VishnuMano/implementing-a-risc-v-chip/results/images/23-floorplan.png

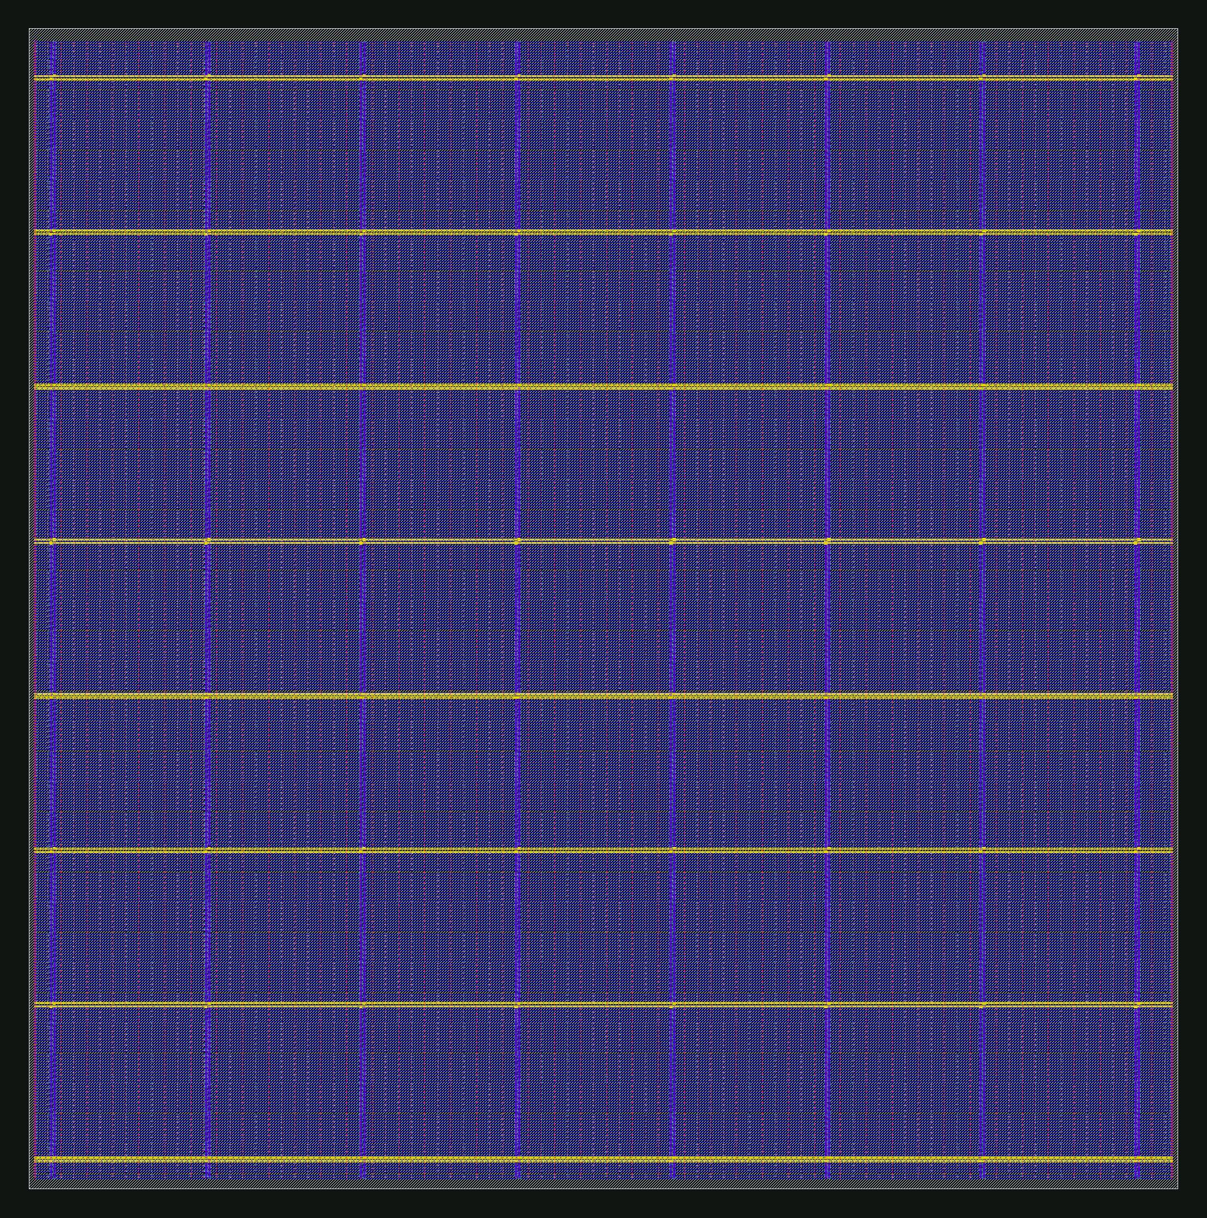
results/images/23-floorplan.png
