VishnuMano/implementing-a-risc-v-chip/results/images/31-placement.png

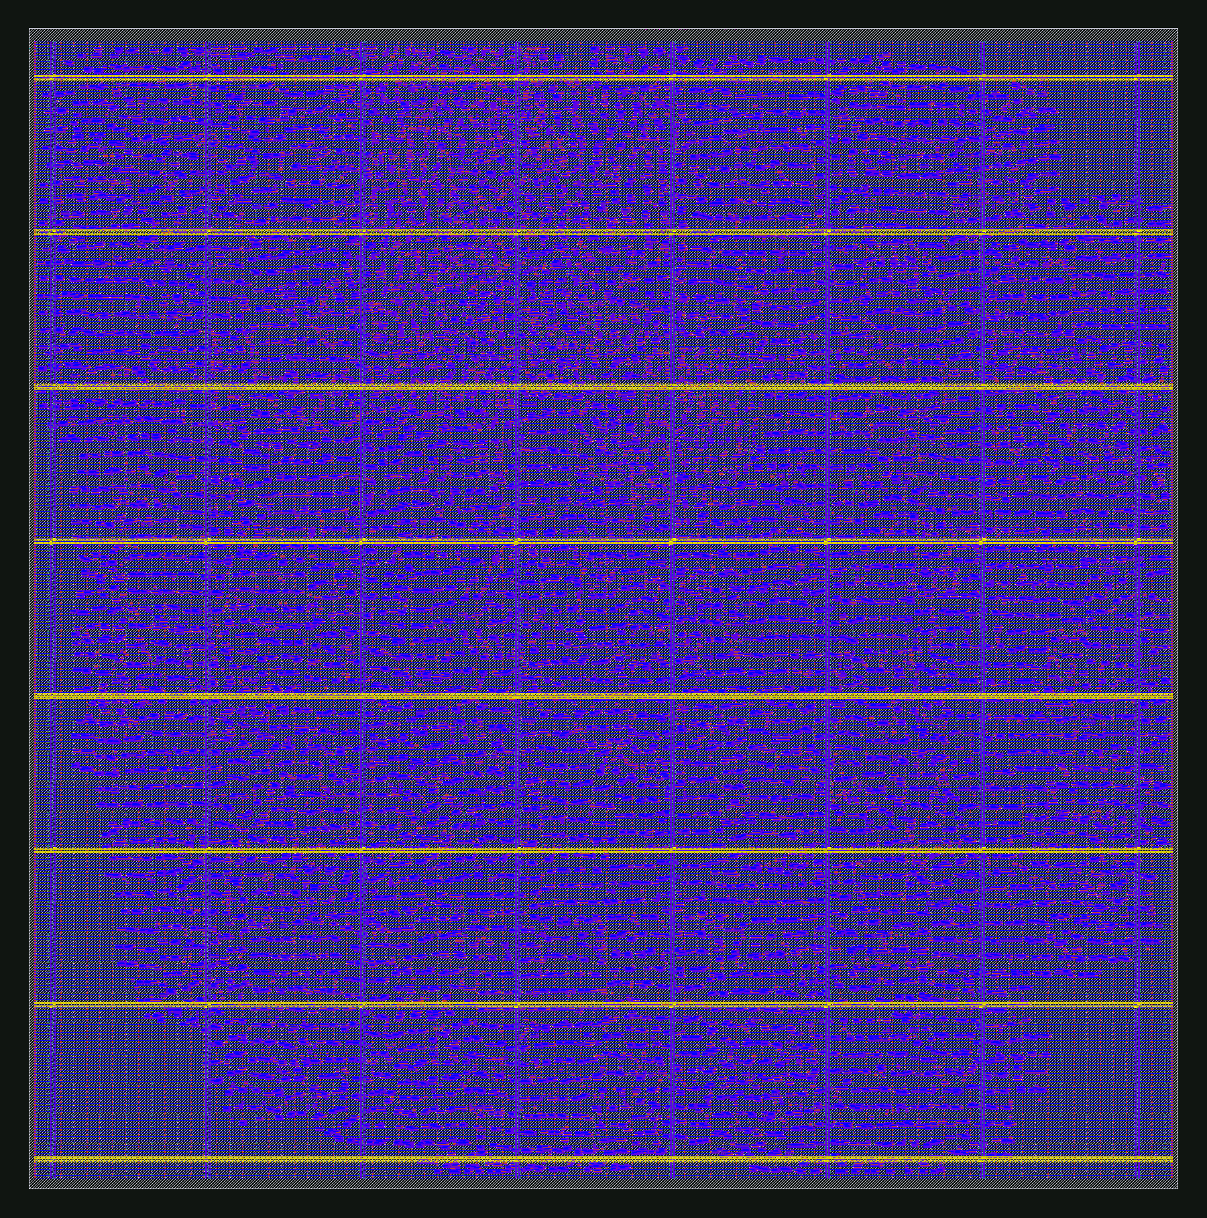
results/images/31-placement.png
