VishnuMano/implementing-a-risc-v-chip/results/images/38-clock-tree.png

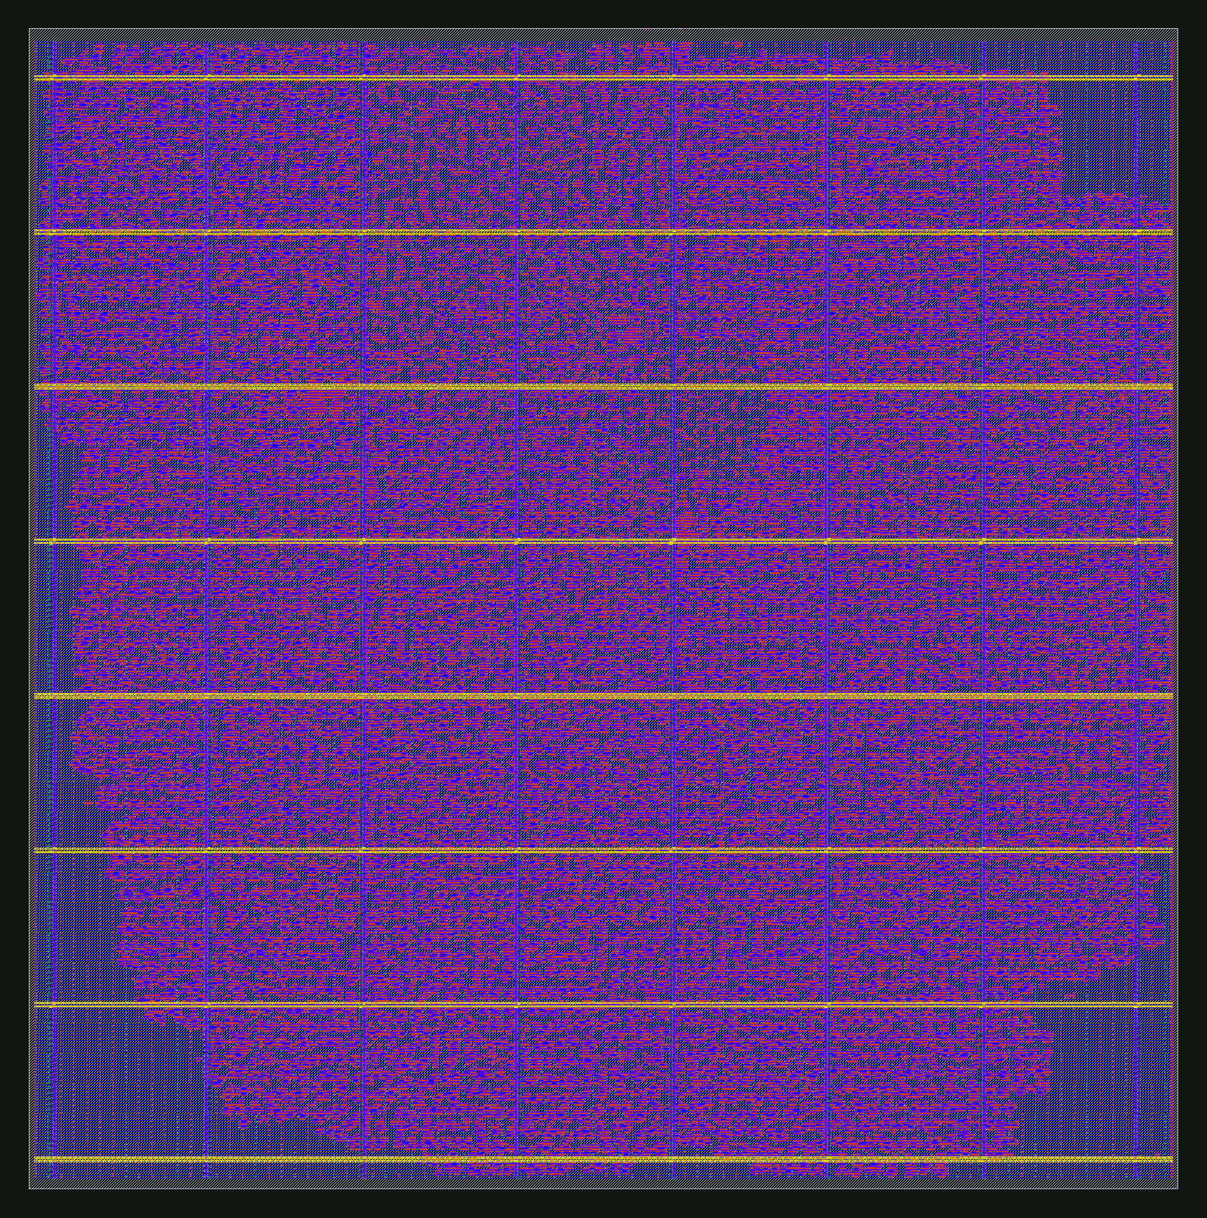
results/images/38-clock-tree.png
