VishnuMano/implementing-a-risc-v-chip/results/images/43-global-routing.png

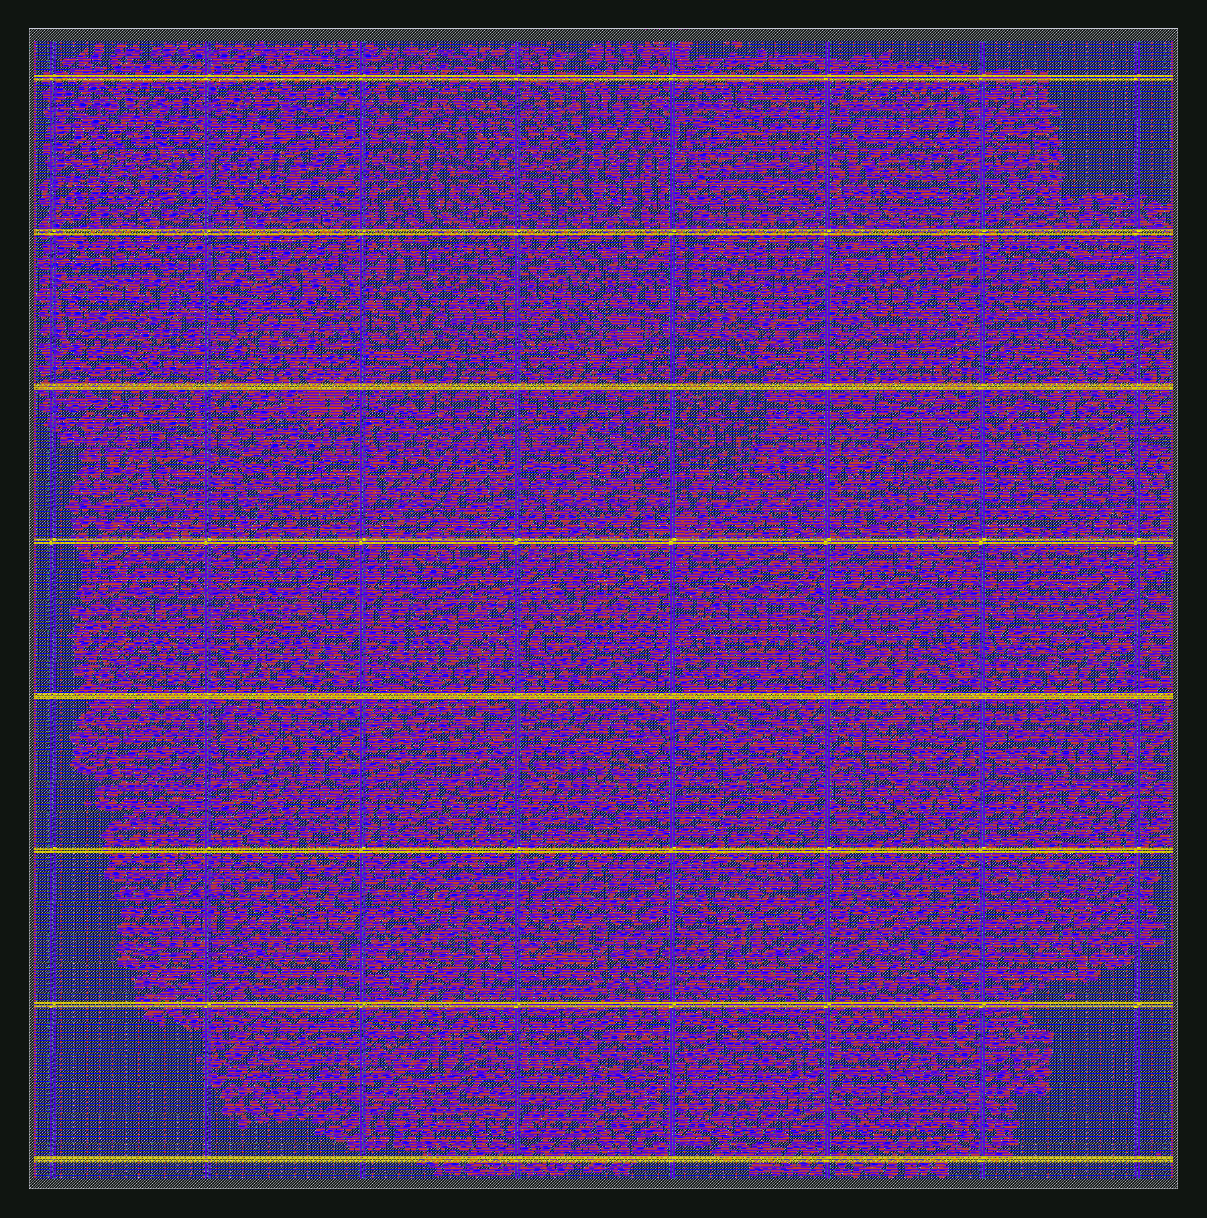
results/images/43-global-routing.png
