VishnuMano/implementing-a-risc-v-chip/results/images/55-detailed-routing.png

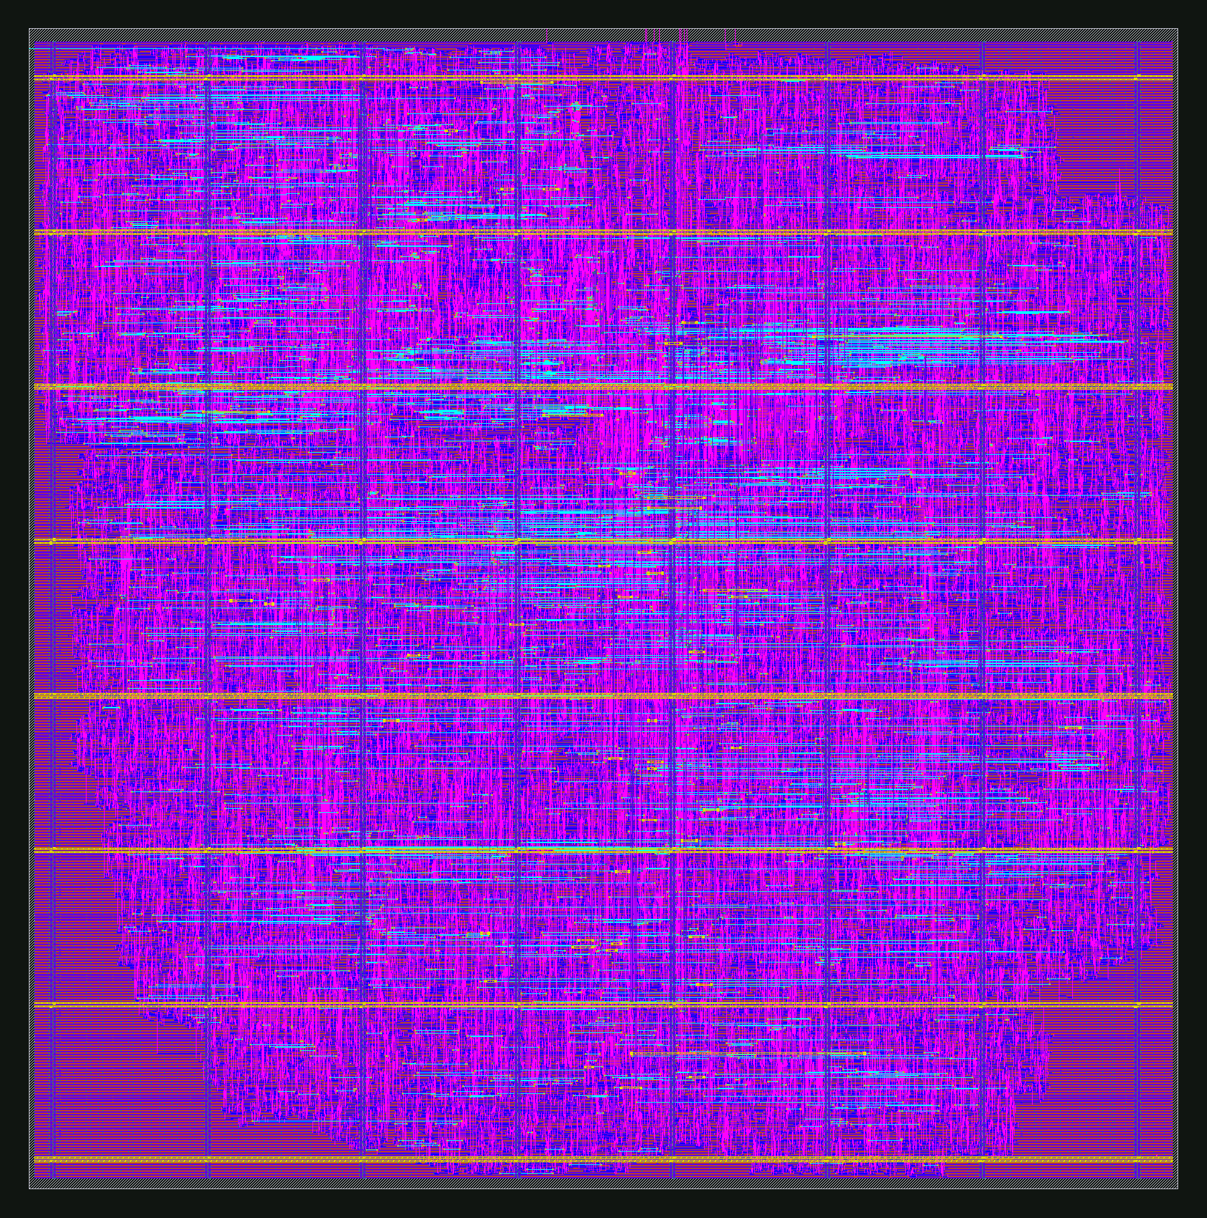
results/images/55-detailed-routing.png
