VishnuMano/implementing-a-risc-v-chip/results/images/final-gds.png

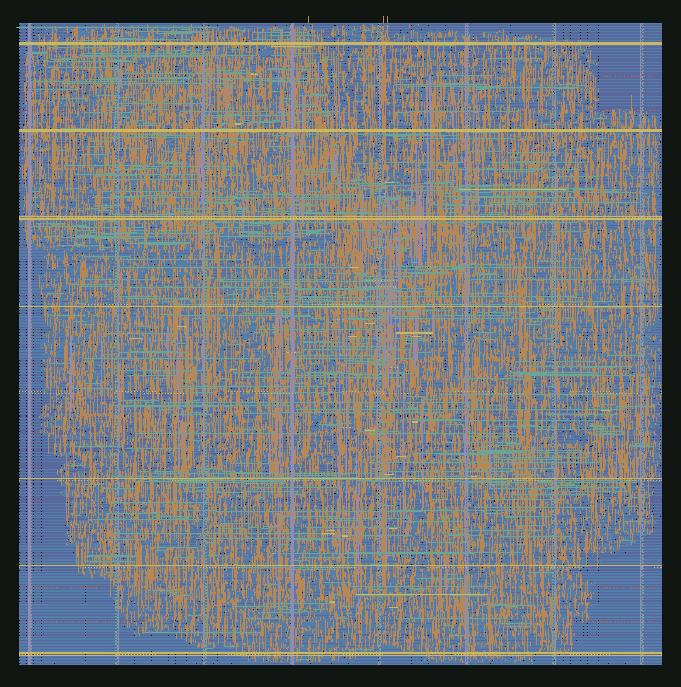
results/images/final-gds.png
