VishnuMano/implementing-a-risc-v-chip/results/images/final-metal.png

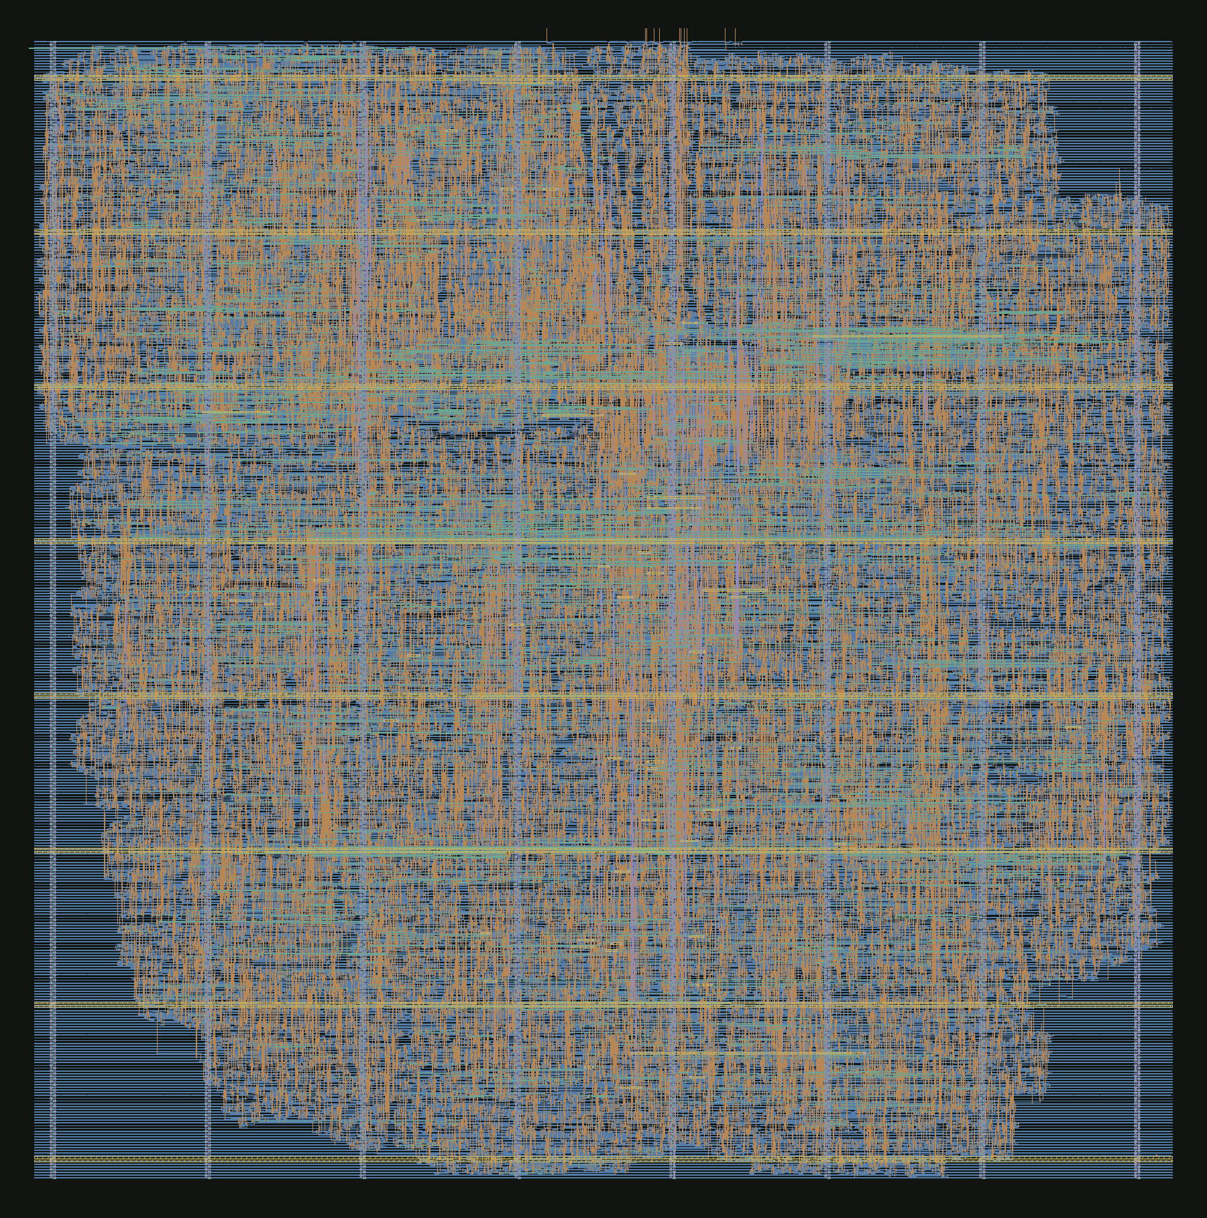
results/images/final-metal.png
