VishnuMano/implementing-a-risc-v-chip/rtl/boot_rom.v

// Generated from firmware; regenerate with make firmware.
`default_nettype none
module boot_rom(input wire [9:0] addr, output reg [31:0] data);
always @* begin
    case (addr)
        10'd0: data = 32'h10000117;
        10'd1: data = 32'h40010113;
        10'd2: data = 32'h10000297;
        10'd3: data = 32'hff828293;
        10'd4: data = 32'h10000317;
        10'd5: data = 32'h07030313;
        10'd6: data = 32'h0062f863;
        10'd7: data = 32'h0002a023;
        10'd8: data = 32'h00428293;
        10'd9: data = 32'hff5ff06f;
        10'd10: data = 32'h034000ef;
        10'd11: data = 32'h0000006f;
        10'd12: data = 32'h20000637;
        10'd13: data = 32'h00460793;
        10'd14: data = 32'h00054683;
        10'd15: data = 32'h00069463;
        10'd16: data = 32'h00008067;
        10'd17: data = 32'h00150513;
        10'd18: data = 32'h0007a703;
        10'd19: data = 32'h00177713;
        10'd20: data = 32'hfe071ce3;
        10'd21: data = 32'h00d62023;
        10'd22: data = 32'hfe1ff06f;
        10'd23: data = 32'hff010113;
        10'd24: data = 32'h200007b7;
        10'd25: data = 32'h10000737;
        10'd26: data = 32'h00c7a583;
        10'd27: data = 32'h00112623;
        10'd28: data = 32'h00812423;
        10'd29: data = 32'h00000793;
        10'd30: data = 32'h00070713;
        10'd31: data = 32'h02000513;
        10'd32: data = 32'h00479613;
        10'd33: data = 32'h00279693;
        10'd34: data = 32'h05a64613;
        10'd35: data = 32'h00d706b3;
        10'd36: data = 32'h00c6a023;
        10'd37: data = 32'h00178793;
        10'd38: data = 32'hfea794e3;
        10'd39: data = 32'h00000793;
        10'd40: data = 32'h00000413;
        10'd41: data = 32'h02000613;
        10'd42: data = 32'h00279693;
        10'd43: data = 32'h00d706b3;
        10'd44: data = 32'h0006a683;
        10'd45: data = 32'h00178793;
        10'd46: data = 32'h00d40433;
        10'd47: data = 32'hfec796e3;
        10'd48: data = 32'h00002737;
        10'd49: data = 32'h200007b7;
        10'd50: data = 32'h04070713;
        10'd51: data = 32'h00878793;
        10'd52: data = 32'h00e41863;
        10'd53: data = 32'h20000737;
        10'd54: data = 32'h00c72703;
        10'd55: data = 32'h02b71463;
        10'd56: data = 32'h0ee00713;
        10'd57: data = 32'h00e7a023;
        10'd58: data = 32'h15800513;
        10'd59: data = 32'hf45ff0ef;
        10'd60: data = 32'h00c12083;
        10'd61: data = 32'h00812403;
        10'd62: data = 32'h00000513;
        10'd63: data = 32'h01010113;
        10'd64: data = 32'h00008067;
        10'd65: data = 32'h0a500713;
        10'd66: data = 32'h00e7a023;
        10'd67: data = 32'h16000513;
        10'd68: data = 32'hf21ff0ef;
        10'd69: data = 32'h20000537;
        10'd70: data = 32'h01c00713;
        10'd71: data = 32'h18400693;
        10'd72: data = 32'h00450613;
        10'd73: data = 32'hffc00593;
        10'd74: data = 32'h00e457b3;
        10'd75: data = 32'h00f7f793;
        10'd76: data = 32'h00f687b3;
        10'd77: data = 32'h0007c803;
        10'd78: data = 32'h00062783;
        10'd79: data = 32'h0017f793;
        10'd80: data = 32'hfe079ce3;
        10'd81: data = 32'h01052023;
        10'd82: data = 32'hffc70713;
        10'd83: data = 32'hfcb71ee3;
        10'd84: data = 32'h17c00513;
        10'd85: data = 32'hf99ff06f;
        10'd86: data = 32'h4c494146;
        10'd87: data = 32'h0000000a;
        10'd88: data = 32'h6c6c6548;
        10'd89: data = 32'h7266206f;
        10'd90: data = 32'h52206d6f;
        10'd91: data = 32'h0a214c54;
        10'd92: data = 32'h63656863;
        10'd93: data = 32'h6d75736b;
        10'd94: data = 32'h0078303d;
        10'd95: data = 32'h5341500a;
        10'd96: data = 32'h00000a53;
        10'd97: data = 32'h33323130;
        10'd98: data = 32'h37363534;
        10'd99: data = 32'h42413938;
        10'd100: data = 32'h46454443;
        10'd101: data = 32'h00000000;
        default: data = 32'h00000013; // NOP
    endcase
end
endmodule
`default_nettype wire
